bl-instr/rf-power-meter-cube/blinky-rf-power-meter-schem.png

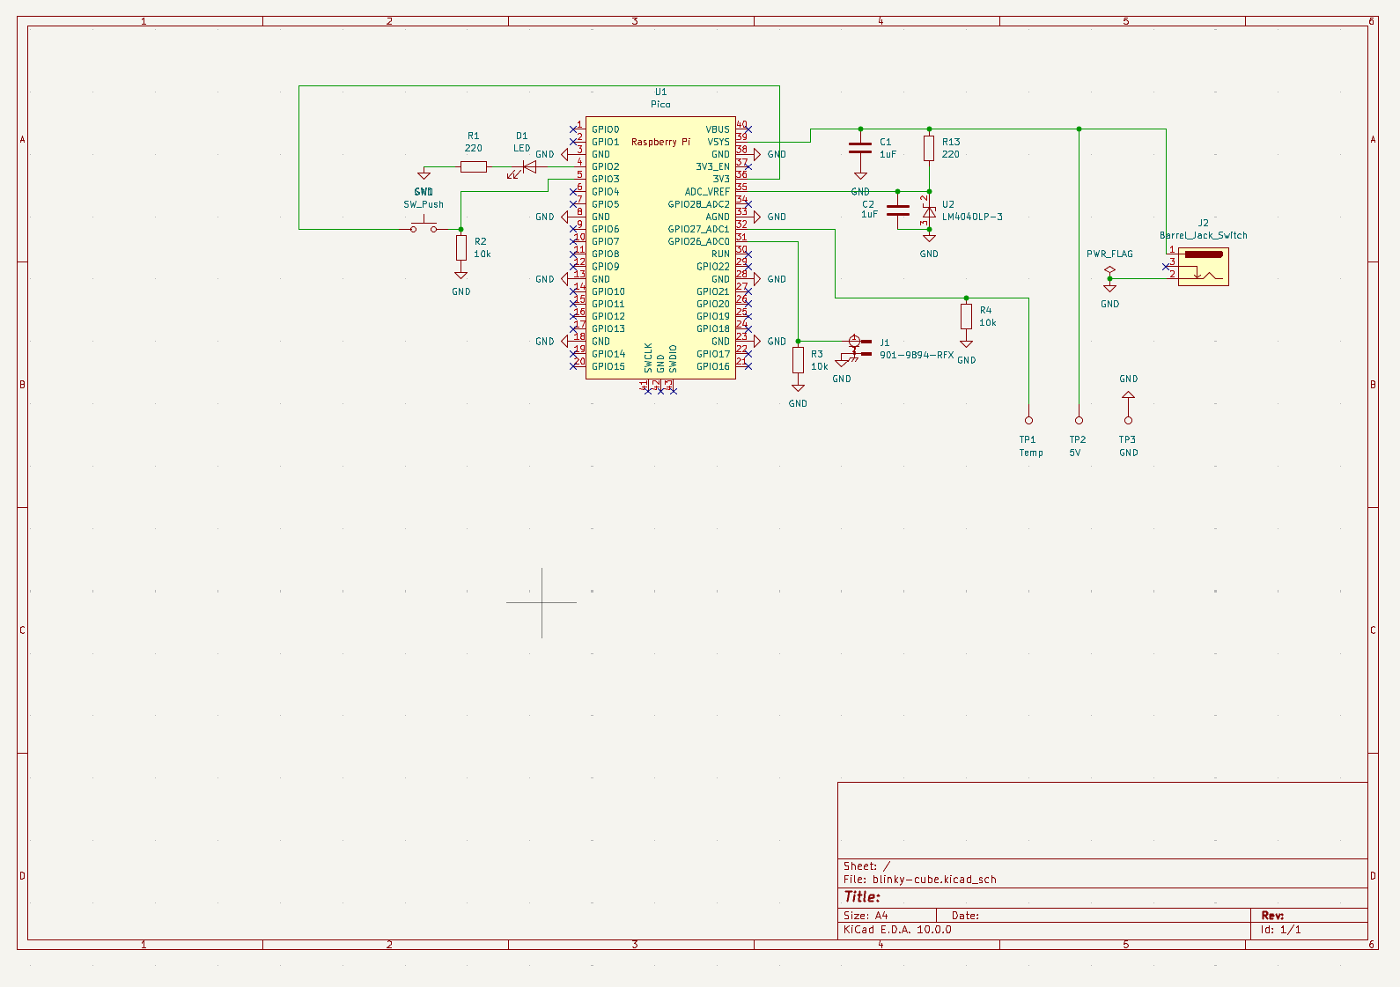
blinky-rf-power-meter-schem.png
