bl-instr/rf-power-meter-cube/schematics/kiCad/amphenol-9019894RFX.png

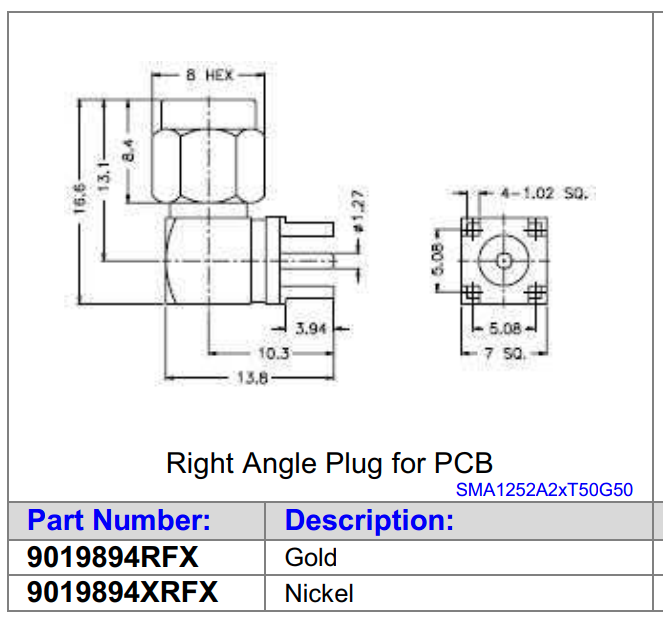
schematics/kiCad/amphenol-9019894RFX.png
