bl-instr/rf-power-meter-cube/schematics/kiCad/blinky-rf-power-meter-pcb-fill.png

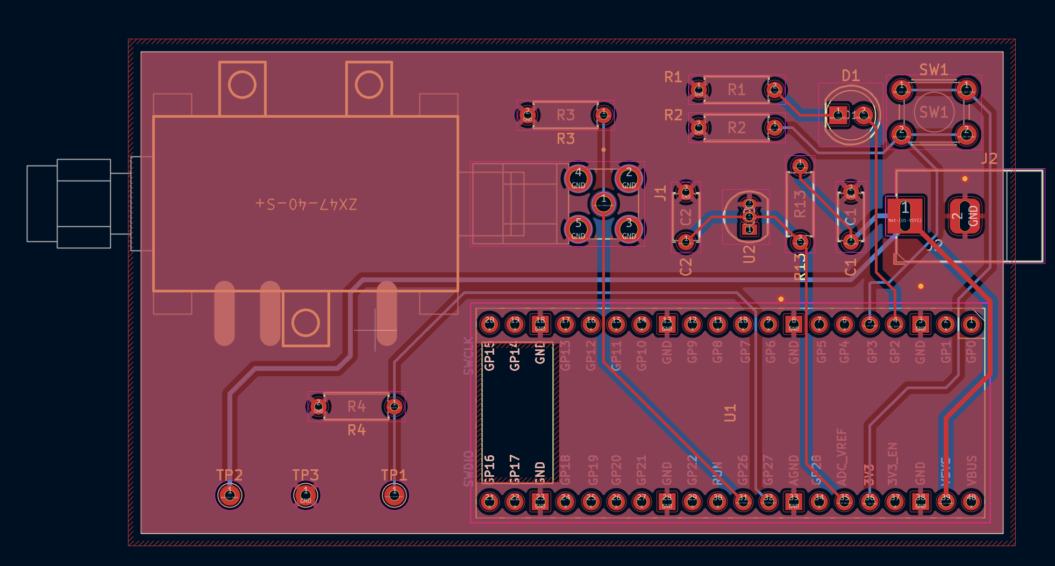
schematics/kiCad/blinky-rf-power-meter-pcb-fill.png
