bl-instr/rf-power-meter-cube/schematics/kiCad/blinky-rf-power-meter-pcb.png

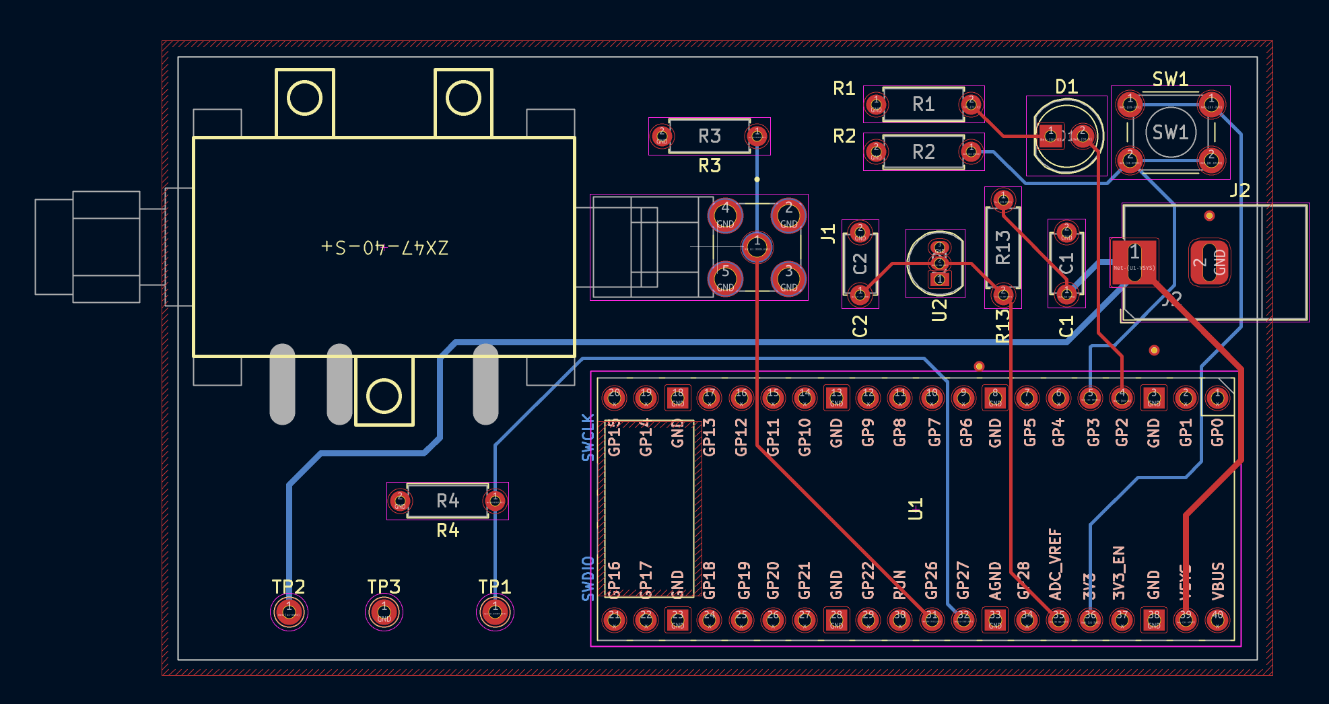
schematics/kiCad/blinky-rf-power-meter-pcb.png
