bl-instr/rf-power-meter-cube/schematics/kiCad/minicircuit-zx47-40.png

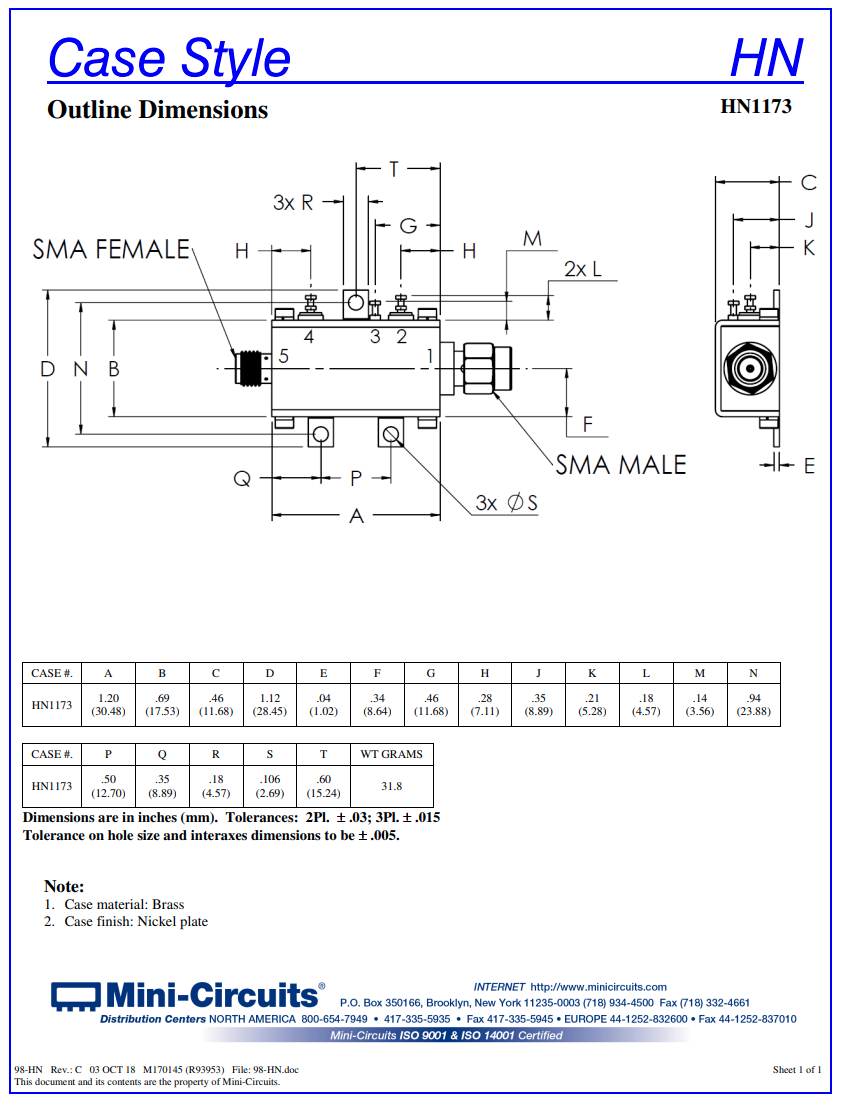
schematics/kiCad/minicircuit-zx47-40.png
