bl-instr/rf-power-meter-cube/schematics/kiCad/blinky-cube.kicad_pcb

## KiCad design schematics/kiCad/blinky-cube.kicad_pcb (2026-07-19)

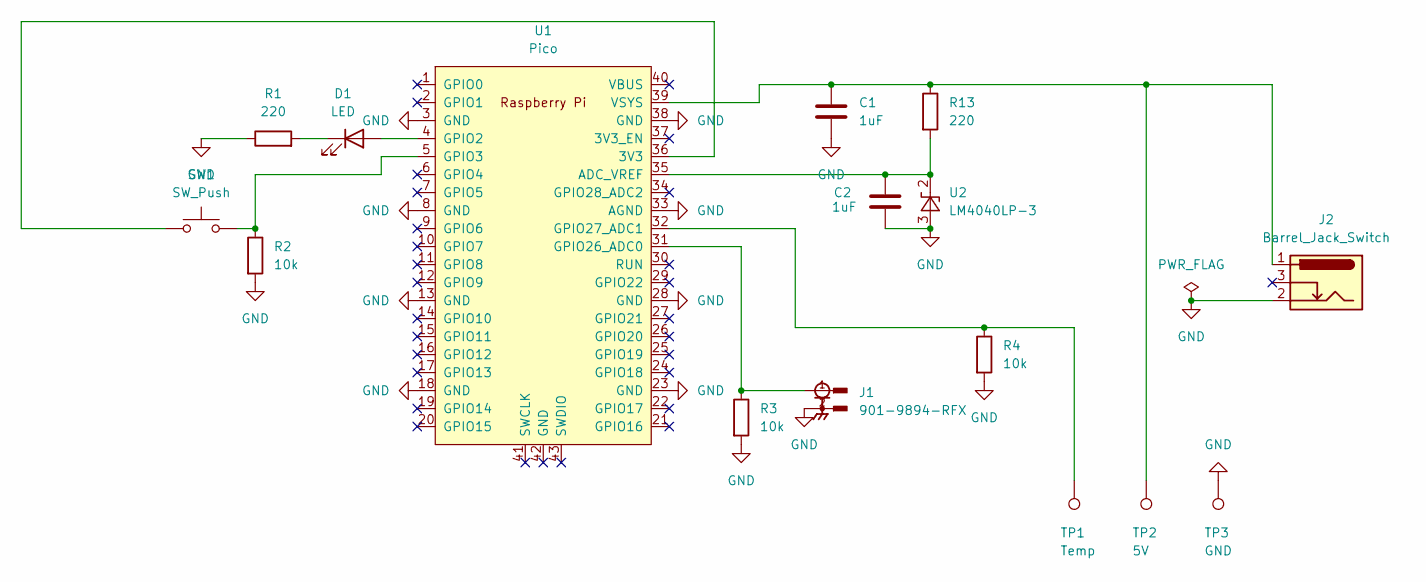
[picture p8: schematic blinky-cube.kicad_sch]

Parts:
C1, C2: 1uF; C_Disc_D4.7mm_W2.5mm_P5.00mm
D1: LED; LED_D5.0mm
J1: 901-9894-RFX; AMPHENOL_901-9894-RFX; PARTREV A
J2: Barrel_Jack_Switch; BarrelJack_HorizontalNC
R1, R13: 220; R_Axial_DIN0207_L6.3mm_D2.5mm_P7.62mm_Horizontal
R2, R3, R4: 10k; R_Axial_DIN0207_L6.3mm_D2.5mm_P7.62mm_Horizontal
SW1: SW_Push; SW_PUSH_6mm
TP1: Temp; TestPoint_THTPad_D2.0mm_Drill1.0mm
TP2: 5V; TestPoint_THTPad_D2.0mm_Drill1.0mm
TP3: GND; TestPoint_THTPad_D2.0mm_Drill1.0mm
U1: Pico; RPi_Pico_SMD_TH
U2: LM4040LP-3; TO-92_Inline

Connections:
GND: C1.2, C2.2, J1.2, J1.3, J1.4, J1.5, J2.2, R1.1, R2.2, R3.2, R4.2, TP3.1 (1_1), U1.3 (GND), U1.8 (GND), U1.13 (GND), U1.18 (GND), U1.23 (GND), U1.28 (GND), U1.33 (AGND), U1.38 (GND), U2.3 (A)
unnamed: D1.2 (A), U1.4 (GPIO2)
unnamed: D1.1 (K), R1.2
unnamed: SW1.1, U1.36 (3V3)
unnamed: C2.1, R13.2, U1.35 (ADC_VREF), U2.2 (K)
unnamed: R2.1, SW1.2, U1.5 (GPIO3)
unnamed: J1.1, R3.1, U1.31 (GPIO26_ADC0)
unnamed: R4.1, TP1.1 (1_1), U1.32 (GPIO27_ADC1)
unnamed: C1.1, J2.1, R13.1, TP2.1 (1_1), U1.39 (VSYS)

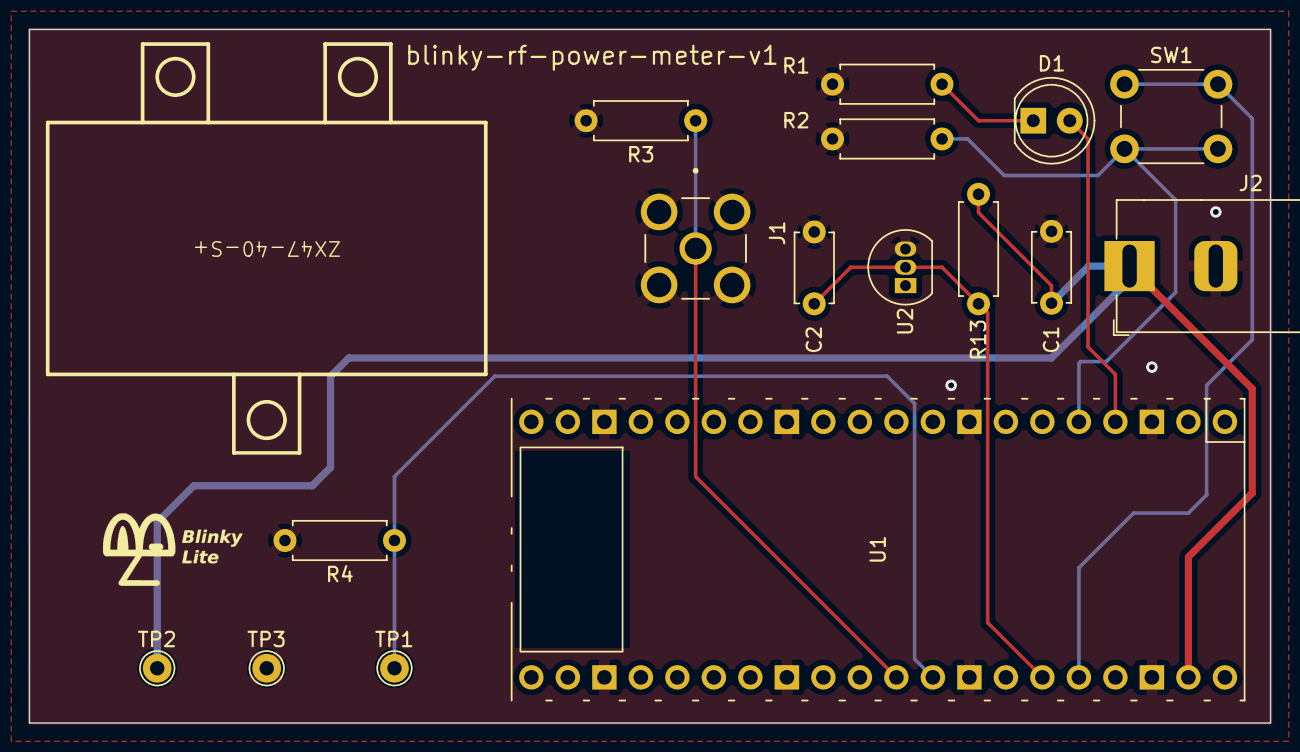
[picture p9: board blinky-cube.kicad_pcb from above]

Board: 2 copper layers, 86.4 x 48.3 mm, 16 parts (0 on the bottom side), 9 nets.
