bl-instr/rf-power-meter-cube/(commit log)

2026-08-19 working from adc cube
2026-10-19 added pcb photo
